oskitone/higher_lower/(notices)

Notices in the files:
kicad/higher_lower.kicad_pcb:
CC BY-SA 4.0
